bonbon08/pico-ledmatrix/README.md

# Pico LED-Matrix 16×16

Vier günstige WS2812B-8×8-Matrizen an einem Raspberry Pi Pico, zusammen eine Fläche von 16×16 Pixeln, versorgt nur über USB.
Dazu gehören 26 Animationen in MicroPython, eine PC-Oberfläche zum Hochladen und Streamen und ein Gehäuse zum 3D-Drucken.

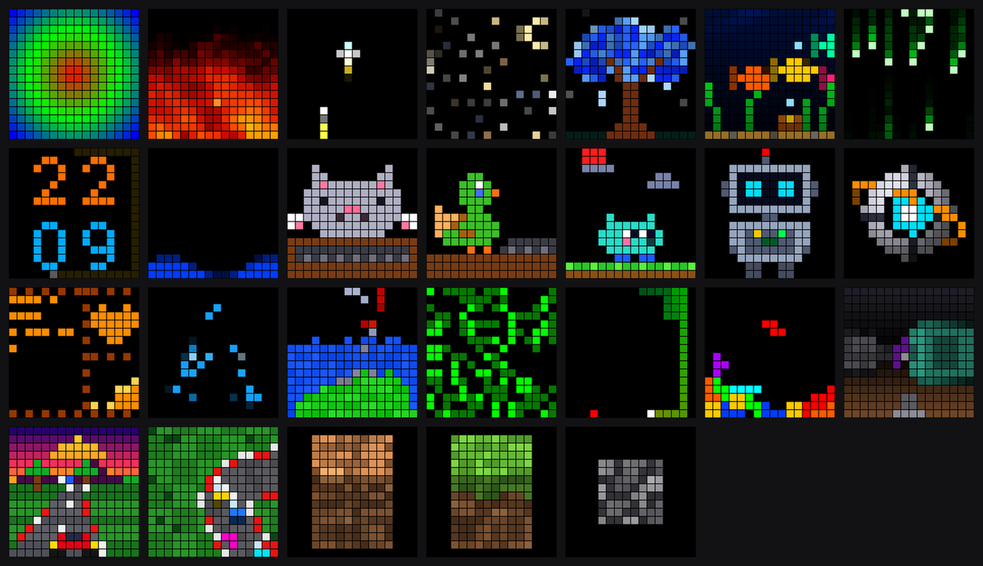
[picture p1: bilder/uebersicht.png]
Alle Demos auf einen Blick (PC-Vorschau)


*Die Bilder sind PC-Vorschauen von `tools/vorschau.py`, keine Fotos der echten Matrix.*

**Was es kann**

- **26 Demos**, die ohne PC laufen: Feuer, Feuerwerk, Aquarium, Uhr, Game of Life, ein Physik-Sandkasten, ein Raycasting-Shooter, zwei Autorennen, rotierende 3D-Blöcke und mehr.
- **Mit dem PC:** Sound-Visualizer, Video und Bildschirm live, eigene Bilder und GIFs, eine Bongo-Katze und eine Ente, die bei jedem Tastendruck mittippen.
- **Eine GUI** (`tools/gui.py`) für alles, mit Live-Vorschau jeder Demo auf dem PC.
- **Kein Netzteil nötig:** `matrix.py` dimmt auf etwa 6 % und begrenzt den Gesamtstrom, so reichen die 500 mA eines USB-Ports.
- **Parametrisches Gehäuse** in OpenSCAD mit Pixelraster und Diffusor.

**Schnellstart**

```bash
# MicroPython auf den Pico flashen (https://micropython.org/download/RPI_PICO/), dann:
uvx mpremote cp matrix.py :matrix.py + cp demos/feuer.py :main.py + reset
# oder alles über die GUI (braucht Python 3 mit tkinter, Pillow, pyserial):
python tools/gui.py
```

**Weitere Dokumentation**

- [Technischer Bericht](docs/technischer-bericht.md): Aufbau, Stromversorgung, Bildpipeline, Protokolle, Leistung, offene Punkte
- [Gehäuse](gehaeuse/README.md): Drucken, Zusammenbau, LED-Abstand ausmessen
- Diese Datei: Hardware, alle Demos, GUI, Werkzeuge und Einstellungen

## Hardware

| Was | Details |
|---|---|
| Controller | Raspberry Pi Pico (RP2040) mit MicroPython |
| LEDs | 4 × WS2812B 8×8 (64 LEDs je Matrix), in Reihe geschaltet |
| Daten | **GP22** → DIN von Matrix 1, DOUT → DIN der nächsten Matrix usw. |
| Versorgung | 5 V von VBUS (USB) und GND gemeinsam mit dem Pico |

### Anordnung der Matrizen

Reihenfolge in der Datenkette (von vorne gesehen):

```
┌─────────┬─────────┐
│    1    │    3    │
│ (0–63)  │(128–191)│
├─────────┼─────────┤
│    2    │    4    │
│ (64–127)│(192–255)│
└─────────┴─────────┘
```

Innerhalb jeder Matrix laufen die LEDs zeilenweise von links nach rechts und dann von oben nach unten, also nicht im Zickzack.

### Koordinaten

`xy(x, y)` rechnet eine Koordinate in den LED-Index um. (0,0) ist oben links, (15,15) unten rechts:

```python
def xy(x, y):
    m = (x // 8) * 2 + (y // 8)          # welche Matrix (0–3)
    return m * 64 + (y % 8) * 8 + (x % 8)
```

## Stromverbrauch und Helligkeit

Bei voller Helligkeit zieht eine WS2812B in Weiß bis zu ca. 60 mA. 256 LEDs kämen damit auf über 15 A, viel zu viel für USB (500 mA).
Deshalb begrenzt `MAX` in `matrix.py` jeden Farbkanal auf **16 von 255**, also etwa 6 %.

Zusätzlich gibt es eine **Strombremse**: `show()` addiert alle Farbwerte. Liegt die Summe über `BUDGET`, wird das ganze Bild gleichmäßig gedimmt. `BUDGET` entspricht dem Regenbogen, bei dem jede LED zusammen 255 hat. Damit bleiben auch Demos mit vielen weißen oder gelben Pixeln im sicheren Bereich.

Grobe Schätzung:

| Verbraucher | Strom |
|---|---|
| Ruhestrom der LEDs (0,6–1 mA pro LED, auch wenn sie aus sind) | 150–250 mA |
| Leuchten bei `MAX = 16` (ca. 1,25 mA pro LED) | ca. 320 mA |
| Pico | ca. 25 mA |
| **Summe** | **ca. 500 mA** |

Das ist etwa die Grenze eines USB-2.0-Ports. Gemessen wurde VSYS über ADC3 (GP29): Die Spannung fiel von 4,71 V (alle LEDs aus) gleichmäßig auf 4,61 V (MAX 22), ohne Einbruch.

> Ohne externes 5-V-Netzteil `MAX` nicht über ca. 22 stellen. Bei Flackern oder Abstürzen auf 12 zurückgehen.
> Mit Netzteil die 5 V direkt an die Matrizen führen und GND mit dem Pico verbinden.

## Dateien

| Datei | Zweck |
|---|---|
| `matrix.py` | Gemeinsame Bibliothek: Koordinaten, Helligkeit, Helligkeitsausgleich, Strombremse |
| `demos/regenbogen.py` | Regenbogen-Ringe von der Mitte nach außen |
| `demos/bloecke.py` | Fallende Blöcke: zufällige Steine aus je vier Pixeln stapeln sich, volle Reihen verschwinden ([Vorschau](bilder/bloecke.png)) |
| `demos/snake.py` | Snake, die von alleine spielt und meist das ganze Feld füllt |
| `demos/gameoflife.py` | Conways Game of Life mit Überblenden und Farbe nach Zellalter |
| `demos/feuer.py` | Lagerfeuer mit Flammenzungen, Wind und aufsteigenden Funken |
| `demos/uhr.py` | Uhr: oben Stunden, unten Minuten, Sekundenring am Rand (60 Pixel) |
| `demos/rennen_oben.py` | Autorennen von oben: 4 Autos auf einer 64×64-Strecke, Kamera fährt mit ([Vorschau](bilder/rennen_oben.png)) |
| `demos/rennen_hinten.py` | Autorennen von hinten (Pseudo-3D) mit Kurven, Sonnenuntergang, Palmen und Gegenverkehr ([Vorschau](bilder/rennen_hinten.png)) |
| `demos/shooter.py` | Ego-Shooter im 90er-Stil, der sich selbst spielt: Raycasting, eigenes Labyrinth, Schleimmonster ([Vorschau](bilder/shooter.png)) |
| `demos/visualizer.py` | Sound-Visualizer: 16 Frequenzbalken vom PC-Ton, braucht `tools/visualizer.py` auf dem PC |
| `demos/bongocat.py` | Bongo-Katze, die bei jedem Tastendruck am PC auf ihre Tastatur haut, braucht `tools/tastatur.py` ([Vorschau](bilder/bongocat.png)) |
| `demos/ente.py` | Tipp-Ente, die bei jedem Tastendruck am PC mit dem Schnabel auf ihre Tastatur pickt, braucht `tools/tastatur.py` ([Vorschau](bilder/ente.png)) |
| `demos/mampf.py` | Mampf, ein runder Knubbel, läuft über die Wiese, saugt herabfallendes Essen ein, kaut, rülpst Sterne und glüht nach Peperoni ([Vorschau](bilder/mampf.png)) |
| `demos/terminal.py` | Altes Bernstein-Terminal: Text tippt sich Zeile für Zeile, dazu Pixel-Symbole und ein hüpfender Pegel ([Vorschau](bilder/terminal.png)) |
| `demos/oslogo.py` | Logo des Betriebssystems vom PC (wie bei fastfetch), baut sich funkelnd auf, mit Glanzstreifen; das Logo erzeugt `tools/oslogo.py` ([Vorschau](bilder/oslogo.png)) |
| `demos/elemente.py` | Physik-Sandkasten: Sand, Wasser, Lava und Samen; Lava + Wasser = Stein + Dampf, Pflanzen wachsen und brennen ([Vorschau](bilder/elemente.png)) |
| `demos/kikern.py` | Rotierende 3D-Panzerkugel mit leuchtendem Auge und Ring, starrt ab und zu rot den Betrachter an ([Vorschau](bilder/kikern.png)) |
| `demos/video.py` | Video vom PC abspielen (16×16, bis 50 Bilder/s), braucht `tools/video.py`; ohne PC pulsiert ein Play-Symbol ([Vorschau](bilder/video.png)) |
| `demos/roboter.py` | Kleiner Roboter, der schaut, blinzelt, winkt, tanzt, sich verliebt und einschläft ([Vorschau](bilder/roboter.png)) |
| `demos/kopfstein.py` | Pflastersteinblock im Minecraft-Stil, der um alle drei Achsen taumelt ([Vorschau](bilder/kopfstein.png)) |
| `demos/matrixcode.py` | Grüner Matrix-Code-Regen mit flackernden Zeichen ([Vorschau](bilder/matrixcode.png)) |
| `demos/erdblock.py` | Rotierender 3D-Erdblock im Minecraft-Stil, optional als Grasblock ([Erde](bilder/erdblock.png), [Gras](bilder/grasblock.png)) |
| `demos/feuerwerk.py` | Feuerwerk mit Kugeln, Ringen, Goldregen und Glitzer, mit Nachleuchten ([Vorschau](bilder/feuerwerk.png)) |
| `demos/aquarium.py` | Aquarium mit Fischen, Seegras, Schatztruhe und Luftblasen ([Vorschau](bilder/aquarium.png)) |
| `demos/sternhimmel.py` | Funkelnde Sterne, Mondsichel und gelegentliche Sternschnuppen ([Vorschau](bilder/sternhimmel.png)) |
| `demos/kirschbaum.py` | Blauer Kirschblütenbaum bei Nacht mit fallenden Blütenblättern ([Vorschau](bilder/kirschbaum.png)) |
| `tools/testbild.py` | Testbild zum Prüfen der Ausrichtung |
| `tools/visualizer.py` | PC-Seite des Sound-Visualizers |
| `tools/tastatur.py` | PC-Seite der Bongo-Katze und der Tipp-Ente: meldet Tastendrücke (nur die Tastaturreihe) und Loslassen an den Pico |
| `tools/oslogo.py` | Holt das Logo von fastfetch, rechnet es auf 16×16 um und lädt es mit der Demo hoch |
| `tools/video.py` | PC-Seite des Videos: dekodiert mit ffmpeg (Dateien oder Links über yt-dlp) und streamt an den Pico |
| `tools/vorschau.py` | Vorschaubild einer Demo auf dem PC erzeugen, ohne Pico; mit `--live` läuft sie in Echtzeit (für die GUI) |
| `tools/bildschirm.py` | PC-Bildschirm live an den Pico streamen (Wayland über die Bildschirmfreigabe, X11 über ffmpeg) |
| `tools/gui.py` | GUI für alles: Demos mit Live-Vorschau, Bilder/GIFs, Video und Bildschirm, OS-Logo, Werkzeuge |
| `tools/starten.sh` | Starter für den Startmenü-Eintrag: holt per `git pull` die neueste Version und startet die GUI |
| `tools/symbol.png` | Symbol für Startmenü und Fenster |
| `demos/_bild.py` | Player für eigene Bilder/GIFs (lädt die GUI zusammen mit `bild.bin` hoch) |
| `gehaeuse/` | 3D-Druck-Gehäuse (OpenSCAD + STL) |

## GUI

```bash
python tools/gui.py
```

Alles, was die Werkzeuge in `tools/` können, geht auch über die GUI. Benötigt werden `tkinter`, Pillow und pyserial, je nach Funktion zusätzlich numpy und `parec` (Visualizer), ffmpeg (Video), fastfetch (OS-Logo) sowie python-gobject und gst-plugin-pipewire (Bildschirm unter Wayland). `mpremote` wird verwendet, wenn es installiert ist, sonst über `uvx mpremote` gestartet.

Oben steht, ob der Pico verbunden ist (grüner Punkt), was gerade auf der Matrix läuft und welcher PC-Sender aktiv ist. Unten steht das Protokoll, es lässt sich ausblenden.

- **Demos:** Eine **Live-Vorschau** lässt die gewählte Demo animiert auf dem PC laufen (`tools/vorschau.py --live`). Über der Liste gibt es eine Suche. „Auf die Matrix laden“, ein Doppelklick oder Enter lädt die Demo hoch, `matrix.py` wird dabei immer mitgeschickt.
  - Bei der **Uhr** übernimmt die GUI die PC-Zeit und startet ohne Reset.
  - Beim **Sound-Visualizer**, der **Bongo-Katze** und der **Tipp-Ente** startet danach der passende PC-Sender. Fehlt das Recht, die Tastatur mitzulesen, steht der nötige Befehl zum Kopieren gleich dabei.
- **Bild / GIF:** PNG, GIF, JPG, BMP oder WebP öffnen. Die Vorschau zeigt das Ergebnis in 16×16, GIFs animiert.
  - *Einpassen* lässt schwarze Ränder, *Zuschneiden* füllt die ganze Fläche, *Strecken* verzerrt.
  - *Helligkeit anheben* streckt alle Bilder mit demselben Faktor so, dass der hellste Wert 255 ist.
  - *Scharf skalieren* ist für Pixel-Art gedacht und wird bei Bildern bis 32 Pixel automatisch eingeschaltet.
  - *GIF-Tempo* von 0,25× bis 3×. Hochgeladen werden höchstens 400 Bilder (etwa 300 KB im Flash).
- **Video & Bildschirm:** Quelle wählen (Videodatei, Link oder den Bildschirm dieses PCs), dazu Zuschnitt, Bilder pro Sekunde, Farbe und Kontrast, beim Bildschirm auch einen Ausschnitt. „Starten“ lädt bei Bedarf den Empfänger (`demos/video.py`) und startet `tools/video.py` bzw. `tools/bildschirm.py`. Daneben steht die Bildrate, die der Pico meldet.
- **OS-Logo:** Logo wählen (Standard: dieser PC, sonst jeder Name aus `fastfetch --list-logos`), Kontrast mit zwei Reglern einstellen, das Ergebnis in 16×16 ansehen und mit der Demo hochladen.
- **Werkzeuge:**
  - Testbild (`tools/testbild.py`), Neustart und Ausschalten (LEDs aus, `main.py` löschen).
  - Uhr stellen.
  - Audioquelle für den Visualizer.
  - Prüfung der Tastatur-Rechte.
  - Dateien und freier Speicher auf dem Pico.
  - **Ins Startmenü:** legt `~/.local/share/applications/ledmatrix.desktop` an. Der Eintrag startet `tools/starten.sh`, das vorher `git pull --ff-only` macht, so läuft immer die neueste Version. Ohne Netz, auf einem anderen Branch oder bei lokalen Änderungen, die im Weg sind, startet die vorhandene Version. Was passiert ist, steht im Protokoll.

Neue Demos in `demos/` erscheinen automatisch in der Liste. Der Name kommt aus `NAMES` in `tools/gui.py`, sonst aus dem Kopfkommentar der Demo (`# Demo: Name. Beschreibung`). Hinweise unter der Beschreibung stehen in `HINTS`. Dateien, die mit `_` beginnen, sind keine Demos.

### Format von `bild.bin`

`b"LEDB"`, Anzahl Bilder (uint16, little endian), dann je Bild: Dauer in ms (uint16) und 768 Byte RGB, zeilenweise von oben links.
Der Player liest die Bilder einzeln aus dem Flash. Deshalb müssen auch lange GIFs nicht in den Arbeitsspeicher.

## Installation

Benötigt wird [`mpremote`](https://docs.micropython.org/en/latest/reference/mpremote.html), z. B. über `uv`.
Zuerst einmal die Bibliothek hochladen, dann die gewünschte Demo als `main.py`:

```bash
uvx mpremote cp matrix.py :matrix.py
uvx mpremote cp demos/regenbogen.py :main.py + reset
```

`main.py` startet automatisch beim Einschalten. Der Treiber `neopixel` ist in MicroPython für den RP2040 schon enthalten.

### Uhr

Der Pico hat keine Uhr mit Batterie. Nach jedem Einstecken und nach jedem Hardware-Reset steht die Zeit auf dem 1.1.2021, die Uhr zeigt dann blinkend `-- --`.
Deshalb die Zeit beim Hochladen vom PC übernehmen und `main.py` ohne Reset starten:

```bash
uvx mpremote cp demos/uhr.py :main.py + rtc --set + exec --no-follow "import main"
```

### Sound-Visualizer

Der PC schneidet den Ton mit, der gerade abgespielt wird (PipeWire/PulseAudio, Monitor des Standard-Ausgangs). Daraus berechnet er 16 logarithmisch verteilte Frequenzbänder von 40 Hz bis 16 kHz und schickt sie etwa 40-mal pro Sekunde per USB an den Pico.
Die Lautstärke wird automatisch nachgeregelt. Kommen 2 Sekunden lang keine Daten an, zeigt der Pico eine blaue Warte-Welle.

```bash
uvx mpremote cp demos/visualizer.py :main.py + reset
python tools/visualizer.py          # benötigt parec, numpy, pyserial; Strg+C beendet
```

Solange `tools/visualizer.py` läuft, belegt es den USB-Port. `mpremote` funktioniert dann nicht.
Übertragen werden nur druckbare Zeichen (`'0'` + Pegel 0–64 je Band, dann ein Zeilenende). So landet nie versehentlich ein Strg+C beim Pico.

### OS-Logo

Zeigt das Logo des Betriebssystems, das `fastfetch` auf dem PC anzeigt. `tools/oslogo.py` holt das farbige ASCII-Logo, zeichnet es mit einer Monospace-Schrift und rechnet es flächengemittelt auf 16×16 herunter. Das Ergebnis (`oslogo.bin`, 768 Byte) wird mit der Demo auf den Pico kopiert. Danach braucht es keinen PC mehr. Ohne `oslogo.bin` zeigt die Demo ein Fragezeichen.

```bash
python tools/oslogo.py --upload                 # Logo dieses PCs
python tools/oslogo.py --logo debian --upload   # anderes Logo (Liste: fastfetch --list-logos)
python tools/oslogo.py --png /tmp/logo.png      # nur ansehen, nichts hochladen
```

Die GUI macht das beim Hochladen der Demo automatisch.

### Video

`tools/video.py` dekodiert ein Video mit ffmpeg, schneidet es quadratisch zu, verkleinert es auf 16×16 und hebt Farbe und Kontrast etwas an. Danach streamt es das Video Bild für Bild an den Pico. Links von Videoseiten löst es mit yt-dlp auf.

```bash
uvx mpremote cp demos/video.py :main.py + reset
python tools/video.py film.mp4                       # einmal abspielen
python tools/video.py film.mp4 --schleife --modus rand   # endlos, ganzes Bild mit Rand
python tools/video.py "https://..." --fps 30         # Link, 30 Bilder/s
```

Pro Bild gehen `#`, 768 Zeichen `0`–`o` (6 Bit je Farbe) und ein Zeilenende zum Pico, also nur druckbare Zeichen. Getestet sind 50 Bilder/s ohne Aussetzer. Kommt der Pico nicht hinterher, lässt der Sender Bilder aus, damit das Video im Takt bleibt. Der Pico meldet alle 5 Sekunden seine Bildrate zurück.

### Bildschirm

`tools/bildschirm.py` zeigt den PC-Bildschirm live auf der Matrix. Auf dem Pico läuft dafür derselbe Empfänger wie beim Video (`demos/video.py`). Unter Wayland läuft die Aufnahme über die Bildschirmfreigabe des Desktops (xdg-desktop-portal und PipeWire). Beim ersten Mal fragt der Desktop in einem Dialog, welcher Bildschirm geteilt werden soll. Die Erlaubnis wird in `~/.cache/ledmatrix-bildschirm.token` gespeichert. Unter X11 nimmt ffmpeg auf.

```bash
python tools/bildschirm.py                        # ganzer Bildschirm, oben/unten schwarzer Rand
python tools/bildschirm.py --bereich 0.25,0.25,0.5,0.5   # nur die Mitte (x, y, Breite, Höhe)
python tools/bildschirm.py --neu                  # Bildschirm neu auswählen
```

### Bongo-Katze

Die Katze haut bei jedem Tastendruck am PC auf ihre Tastatur, abwechselnd mit der linken und der rechten Pfote. Ohne PC trommelt sie im Demo-Modus von selbst, nach 30 Sekunden ohne Tastendruck schläft sie ein.

`tools/tastatur.py` liest die Tastatur direkt aus `/dev/input`. Das funktioniert auch unter Wayland und unabhängig davon, welches Fenster aktiv ist. Dafür muss der Benutzer einmalig in die Gruppe `input`:

```bash
sudo usermod -aG input $USER      # danach ab- und wieder anmelden
uvx mpremote cp demos/bongocat.py :main.py + reset
python tools/tastatur.py
```

Zum Pico geht pro Tastendruck nur ein `k`, nie welche Taste gedrückt wurde. Dazu kommt jede Sekunde ein `.` als Lebenszeichen.
Wichtig: Mit der Gruppe `input` dürfen **alle** Programme dieses Benutzers die Tastatur mitlesen, nicht nur dieses. Wem das zu weit geht, der lässt die Katze im Demo-Modus laufen.

### Tipp-Ente

Funktioniert genauso wie die Bongo-Katze und nutzt denselben Sender: Bei jedem Tastendruck beugt die Ente den Hals vor und pickt auf eine Taste, die aufleuchtet. Welche ihrer drei Tasten, hängt von der Reihe der echten Taste ab: obere Reihen (Ziffern, QWERTZ, F-Tasten) hinten, mittlere Reihe in der Mitte, untere Reihe mit Leertaste vorne, alles andere zufällig. Der Sender schickt dafür nur die Reihe, nie die Taste. Solange eine Taste gehalten wird, bleibt der Schnabel unten. Bei schnellem Tippen richtet sie sich zwischen den Picks nicht ganz auf. Ohne PC pickt sie im Demo-Modus von selbst, nach 30 Sekunden ohne Tastendruck steckt sie den Kopf ein und schläft.

```bash
uvx mpremote cp demos/ente.py :main.py + reset
python tools/tastatur.py
```

## Eigene Demos

```python
import matrix as m

m.clear()
m.set(0, 0, (255, 0, 0))      # Pixel oben links rot, Farben immer 0-255
m.set(15, 15, m.wheel(300))   # Farbe aus dem Farbrad (0-767)
m.show()                      # dimmt, korrigiert und sendet an die LEDs
```

Ein Vorschaubild ohne Pico erzeugt `python tools/vorschau.py demos/meine_demo.py bilder/meine_demo.png 30,60,90`. Die Zahlen sind die Nummern der Bilder, die nebeneinander gezeigt werden.

`show()` braucht etwa 8 ms. Die Umrechnung läuft mit `@micropython.viper` als nativer Code, der Rest ist das Senden an die LEDs.

## Testbild

```bash
uvx mpremote run tools/testbild.py
```

Wenn die Zuordnung stimmt, siehst du:

- **Rot:** die komplette oberste Zeile (16 LEDs)
- **Grün:** die komplette linke Spalte (16 LEDs)
- **Gelb:** einen Punkt bei (1,1)
- **Blau:** einen Punkt ganz unten rechts (15,15)

Das Testbild bleibt nur bis zum nächsten Reset. Danach startet wieder `main.py`.

## Anpassen

- **Helligkeit:** `MAX` in `matrix.py`
- **Helligkeitsausgleich je Matrix und Farbe:** `GAIN` in `matrix.py`. Matrix 1 hat andere LEDs: Rot und Grün leuchten doppelt so hell, Blau etwa 1,45-mal. Sie läuft deshalb mit (0,5; 0,5; 0,69). Die Werte wurden per Auge mit einfarbigen Testbildern abgeglichen.
- **Regenbogen:** Die Geschwindigkeit stellt man über `off + 12` und `time.sleep_ms(20)` ein. Ein größerer Faktor in `int(d * 48)` ergibt schmalere Ringe.
- **Rennen von oben:** Die Strecke steht in `POINTS` als Eckpunkte einer geschlossenen Runde (Welt 64×64). `ROAD` und `CURB` sind die halbe Straßenbreite und die Breite der Randsteine. Die Autofarben stehen in `CARS`. Beim Start wird die Strecke etwa 4 Sekunden lang berechnet, solange ist ein Ladebalken zu sehen.
- **Rennen von hinten:** Die Strecke steht in `TRACK` als Abschnitte (Länge, Krümmung; negativ = links). `SPEED` ist das Tempo, `PX` die Straßenbreite.
- **Shooter:** Das Labyrinth steht in `MAP` (`#` Stein, `B` Ziegel, `T` Technik, `.` frei). `ENEMIES` ist die Anzahl der Gegner, `SHOOT_DIST` der Abstand, ab dem geschossen wird. `MOVE` und `TURN` bestimmen das Tempo.
- **Roboter:** Farben stehen oben in der Datei. Welche Zustände wie oft vorkommen, regelt `next_state()`.
- **Pflasterstein:** `SPIN` ist das Drehtempo um die drei Achsen, `STONES` das Steinmuster (8×8).
- **Matrix-Code:** `DROPS` ist die Anzahl der Spuren pro Spalte, `DECAY` die Schweiflänge, `GLYPH_FLIP` wie oft Zeichen wechseln.
- **Erdblock:** Mit `GRASS = True` wird daraus ein Grasblock. `SPIN` ist das Drehtempo, `TILT` die Neigung (negativ = von oben gesehen), `ZOOM` die Größe (kleiner = größer).
- **Feuerwerk:** `LAUNCH` ist die Häufigkeit der Raketen, `FINALE` die Häufigkeit eines Finales mit 4 Raketen. `TRAIL` bestimmt die Länge der Leuchtspuren. `MAX_SPARKS` begrenzt die Funken, damit der Pico flüssig bleibt.
- **Aquarium:** `FISH` ist die Anzahl der Fische (Farben in `FISH_COLS`), `BUBBLE_RATE` die Häufigkeit der Luftblasen. Die Fischform steht in `FISH_ART`, das Seegras in `WEEDS` als (x, Höhe).
- **Sternhimmel:** `STARS` ist die Anzahl der Sterne, `SHOOT` die Häufigkeit der Sternschnuppen (0,006 = etwa alle 7 Sekunden). Mit `MOON` lässt sich der Mond ein- und ausschalten.
- **Kirschbaum:** Die Form steht als Pixel-Art in `ART` (B = Blüte, T = Stamm, G = Boden, * = Stern), die Farben in `BLUES`. `PETALS` und `PETAL_RATE` steuern die Blütenblätter.
- **Tipp-Ente:** Die Ente steht als Pixel-Art in `ART` (Körper) und `HEAD` (Kopfhaltungen, darunter eine pro Taste), die Farben in `COL`. In `KEYS` steht je Taste die Kopfhaltung, die leuchtenden Pixel und die Stelle der Funken. `PECK` ist der Ablauf eines Picks (eine Zahl pro Bild), `SLEEP_AFTER` die Zeit bis zum Einschlafen.
- **Mampf:** `SPAWN` ist die Häufigkeit des Essens, `MAX_ITEMS` die Höchstzahl gleichzeitig. Das Essen steht in `ITEMS` als 3×3-Pixel-Art mit Gewicht (je höher, desto häufiger). `SPEED` und `HOT_SPEED` sind das Lauftempo, `BURP_AFTER` die Happen bis zum Rülpser. Die Figur steht in `BODY`, `MOUTH` und `FEET`, die Farben in `COL`.
- **Terminal:** `TYPE_FRAMES` ist das Tipptempo, `LINE_PAUSE` und `VERSE_PAUSE` die Pausen nach Zeile und Strophe, `VERSE_LINES` die Zeilen pro Strophe. Die Symbole stehen in `ICONS` (6×6), die Farben in `AMBER`, `FRESH` und `FRAME`.
- **OS-Logo:** `HOLD` ist die Standzeit, `GLINT_EVERY` der Abstand der Glanzstreifen, `BUILD_SPEED` das Tempo von Aufbau und Zerfall. In `tools/oslogo.py` regeln `LOW` und `HIGH` den Kontrast beim Umrechnen (höheres `LOW` = weniger schwache Randpixel), `ANSI` die Farben.
- **Elemente:** In `POUR` stehen die Gieß-Phasen (Material, alle wie viele Bilder ein Pixel, Gewicht). `FULL` ist die Füllung, ab der der Boden aufgeht, `KEEP` wie viel dabei übrig bleibt. Farben in `PAL`, Flackern und Körnung in `VAR`. Die Regeln (wer sinkt durch wen, Reaktionen) stehen in `step()`, die Dichten in `MD` und `TD`.
- **KI-Kern:** `SPIN` ist das Drehtempo, `TILT` das Kippen, `RADIUS` die Kugelgröße. `STARE_EVERY` und `STARE` regeln das Anstarren. Farben in `ARMOR`, `SEAM`, `EYE` und `ANGRY`. In `RINGS` lassen sich weitere Ringe eintragen (Neigung, Radius, Tempo, Farbe).
- **Video:** Am Sender: `--fps`, `--farbe` (Sättigung, Standard 1,4), `--kontrast` (Standard 1,15), `--modus` (`zuschneiden`, `rand` oder `strecken`), `--schleife`. In der Demo: `TIMEOUT`, nach wie vielen ms ohne Bild das Play-Symbol erscheint.
- **Feuer:** `COOL` bestimmt die Flammenhöhe (größer = niedriger). `EMBER` ist die Häufigkeit der Funken, `WIND` die Häufigkeit von Windwechseln.
- **Game of Life:** `FRAMES` und `FRAME_MS` bestimmen das Tempo (eine Generation = `FRAMES × FRAME_MS`, also ca. 190 ms). `DENSITY` ist die Startdichte beim Zufallsstart.
- **Snake:** `STEP_MS` ist die Zeit pro Schritt. Eine komplette Runde dauert bei 80 ms etwa 15 Minuten.
- **Fallende Blöcke:** `FALL_MS` ist die Fallgeschwindigkeit. `SMART` ist der Anteil der Steine, die gut gelegt werden. Je höher der Wert, desto mehr Reihen werden voll.

## Fehlersuche

- **LEDs bleiben dunkel oder flackern:** Der 3,3-V-Datenpegel des Pico reicht bei 5-V-LEDs manchmal nicht ganz. Hilfreich sind dann ein Widerstand von 330 Ω in der Datenleitung, eine kurze Leitung oder ein Pegelwandler (z. B. 74AHCT125). Außerdem prüfen, ob GND gemeinsam verbunden ist.
- **Farben vertauscht:** Andere LED-Typen verwenden eine andere Kanalreihenfolge (z. B. RGB statt GRB).
- **Bild verdreht oder gespiegelt:** Mit dem Testbild prüfen und `xy()` anpassen.

## Gehäuse

Ein Gehäuse zum 3D-Drucken (Rahmen mit Pixelraster und Diffusor, Deckel mit Pico-Halter) liegt in [`gehaeuse/`](gehaeuse/README.md).

## Lizenz

[MIT](LICENSE), © 2026 bonbon. Das gilt für Code, Gehäuse-Dateien und Bilder in diesem Repository.

Einige Demos sind an bekannte Spielgenres angelehnt („im Minecraft-Stil“, Raycasting-Shooter, fallende Blöcke). Grafik, Levels und Namen sind selbst gemacht, Texturen werden im Code erzeugt. Das Projekt hat nichts mit den Inhabern dieser Spiele oder Marken zu tun. Die OS-Logos erzeugt `fastfetch` auf dem eigenen PC, sie sind nicht Teil des Codes. Das Vorschaubild `bilder/oslogo.png` (und die Kachel in `bilder/uebersicht.png`) zeigt das Arch-Linux-Logo. Es gehört dem Arch-Linux-Projekt und fällt nicht unter die MIT-Lizenz.
