bonbon08/pico-ledmatrix/bilder/aquarium.png

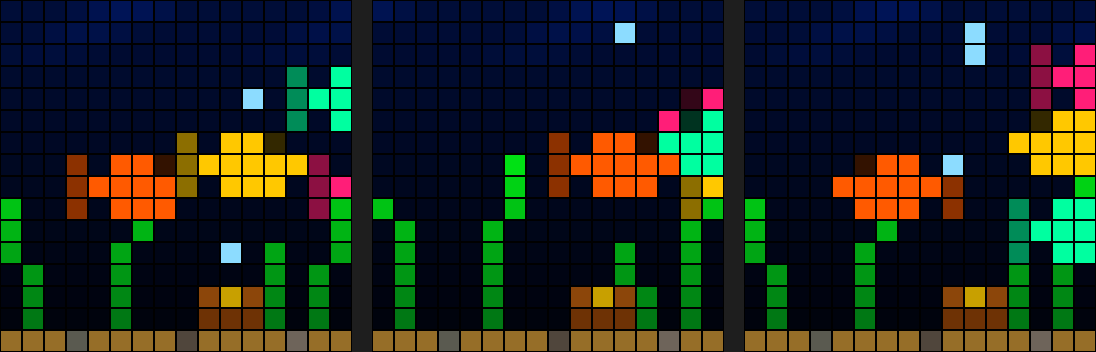
bilder/aquarium.png
