bonbon08/pico-ledmatrix/bilder/bloecke.png

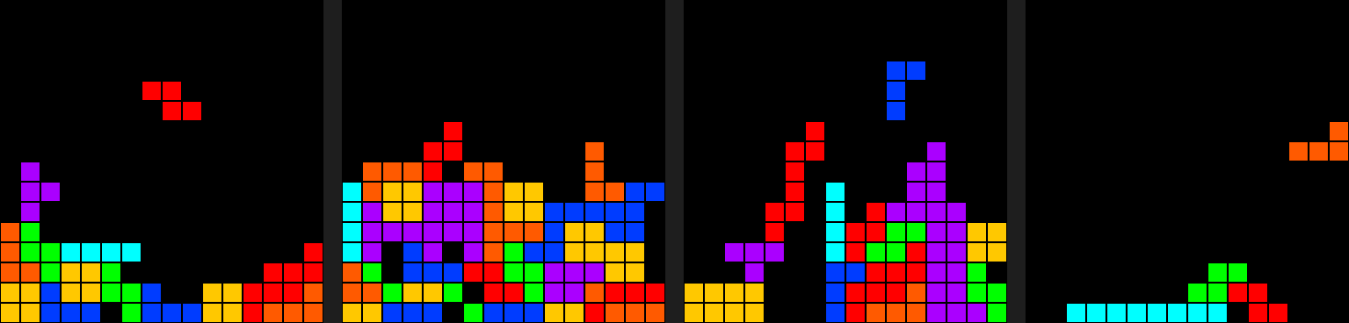
bilder/bloecke.png
