bonbon08/pico-ledmatrix/bilder/bongocat.png

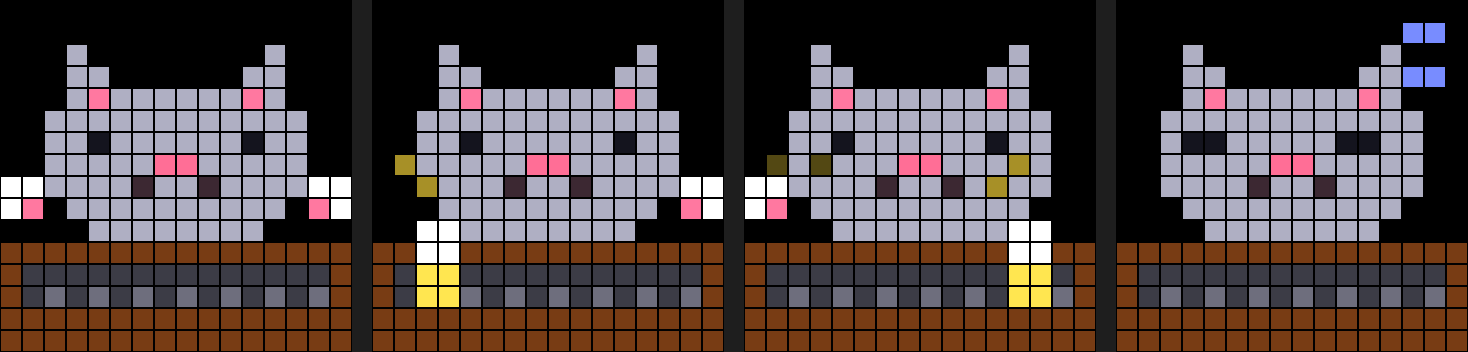
bilder/bongocat.png
