bonbon08/pico-ledmatrix/bilder/elemente.png

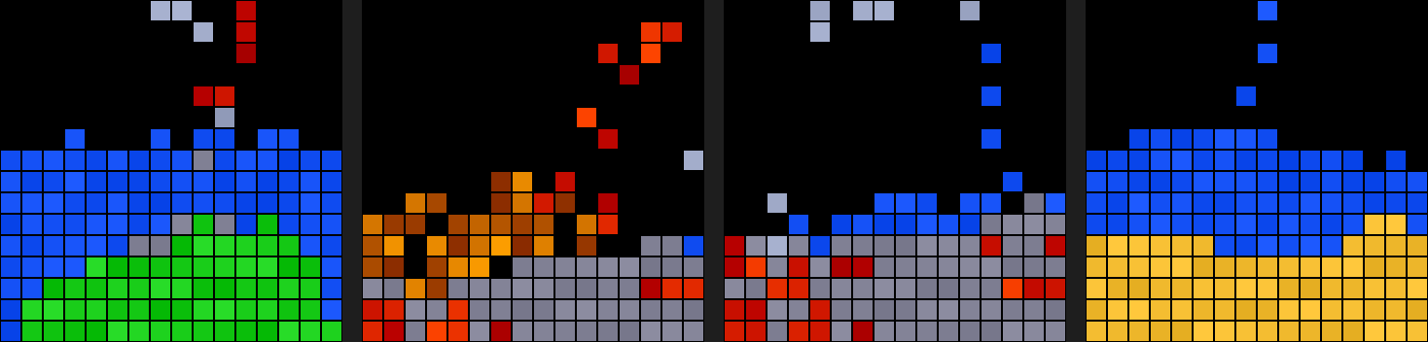
bilder/elemente.png
