bonbon08/pico-ledmatrix/bilder/ente.png

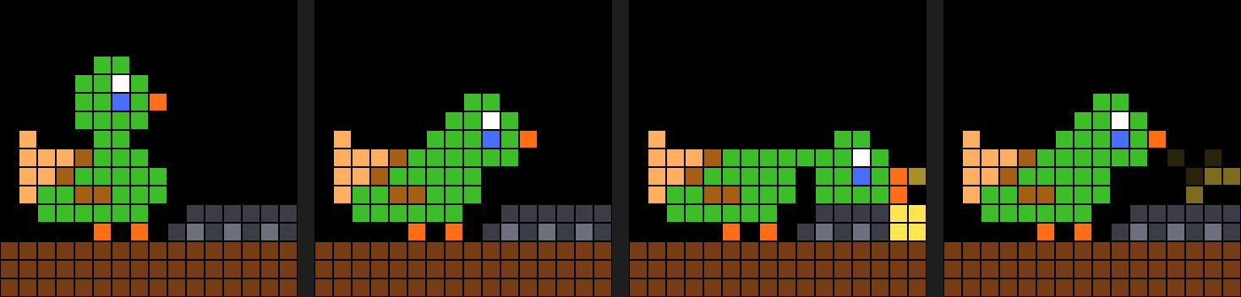
bilder/ente.png
