bonbon08/pico-ledmatrix/bilder/erdblock.png

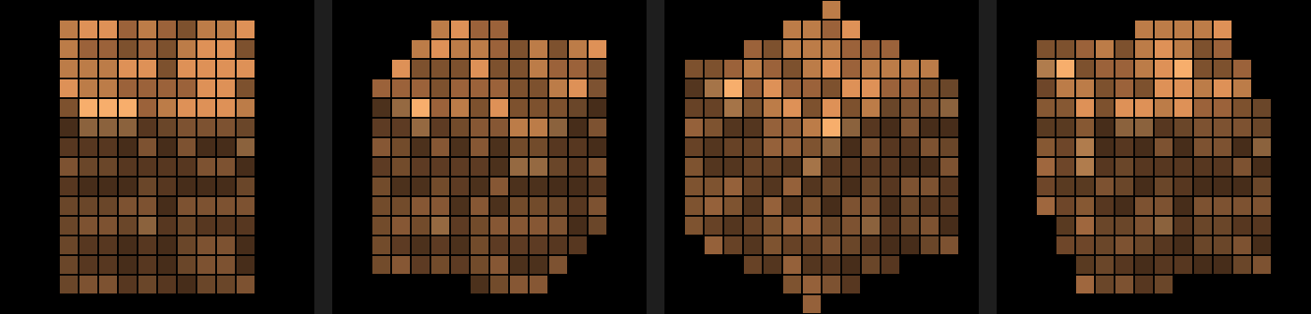
bilder/erdblock.png
