bonbon08/pico-ledmatrix/bilder/feuer.png

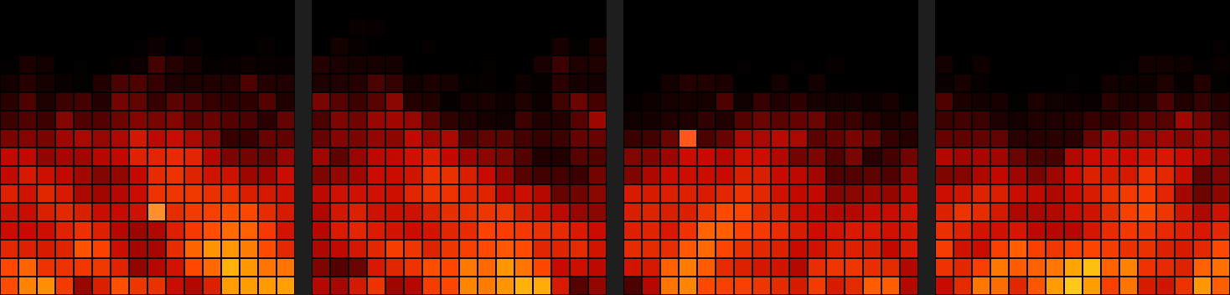
bilder/feuer.png
