bonbon08/pico-ledmatrix/bilder/feuerwerk.png

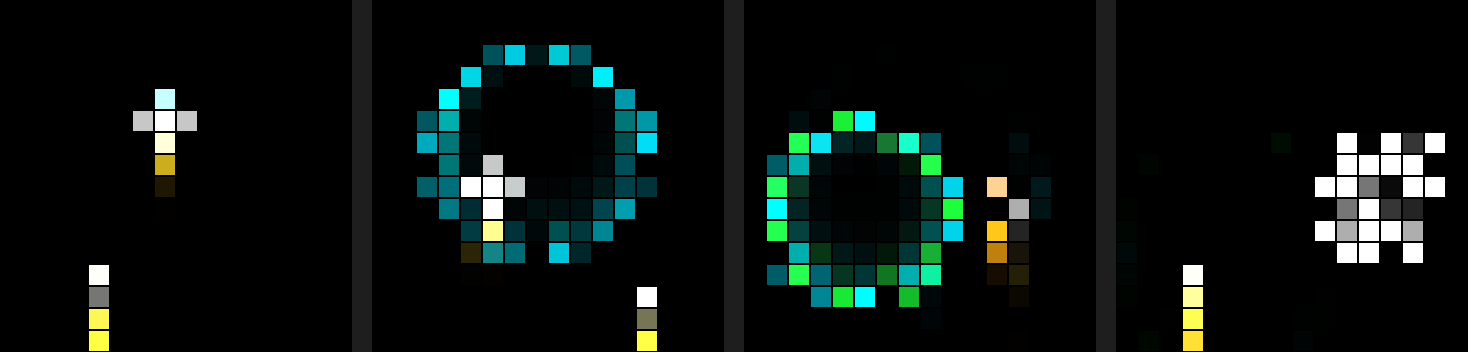
bilder/feuerwerk.png
