bonbon08/pico-ledmatrix/bilder/gameoflife.png

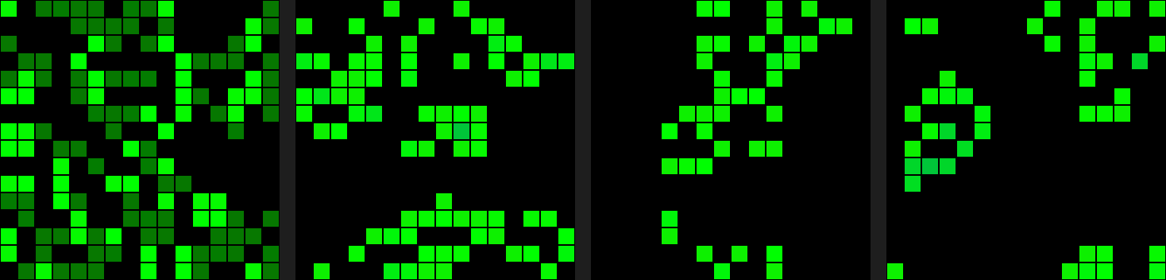
bilder/gameoflife.png
