bonbon08/pico-ledmatrix/bilder/kikern.png

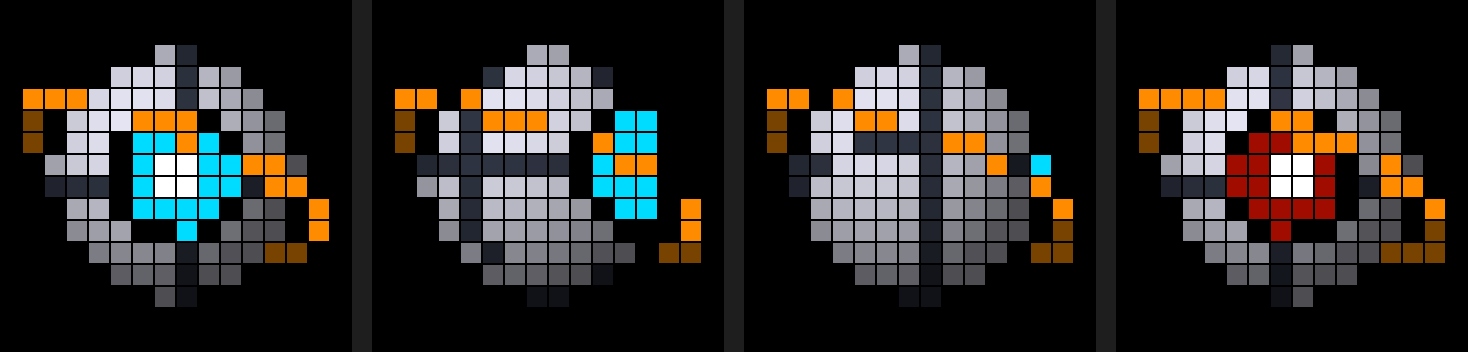
bilder/kikern.png
