bonbon08/pico-ledmatrix/bilder/kirschbaum.png

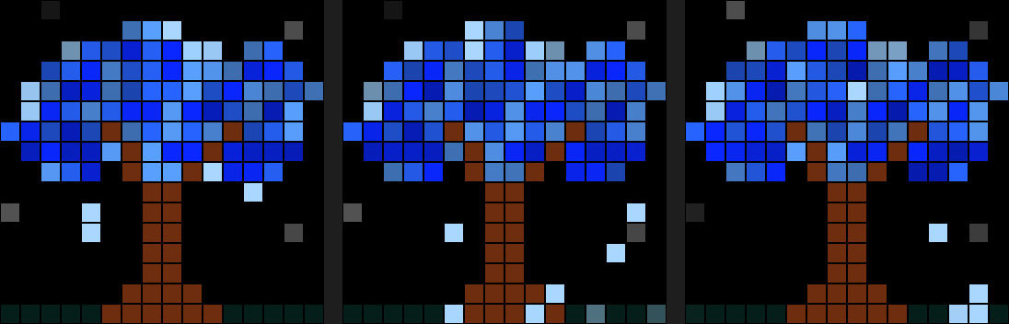
bilder/kirschbaum.png
