bonbon08/pico-ledmatrix/bilder/kopfstein.png

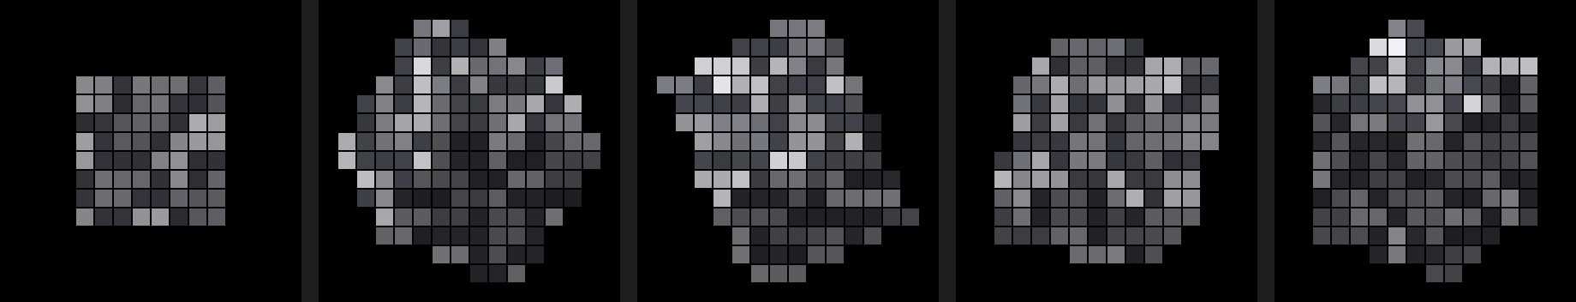
bilder/kopfstein.png
