bonbon08/pico-ledmatrix/bilder/mampf.png

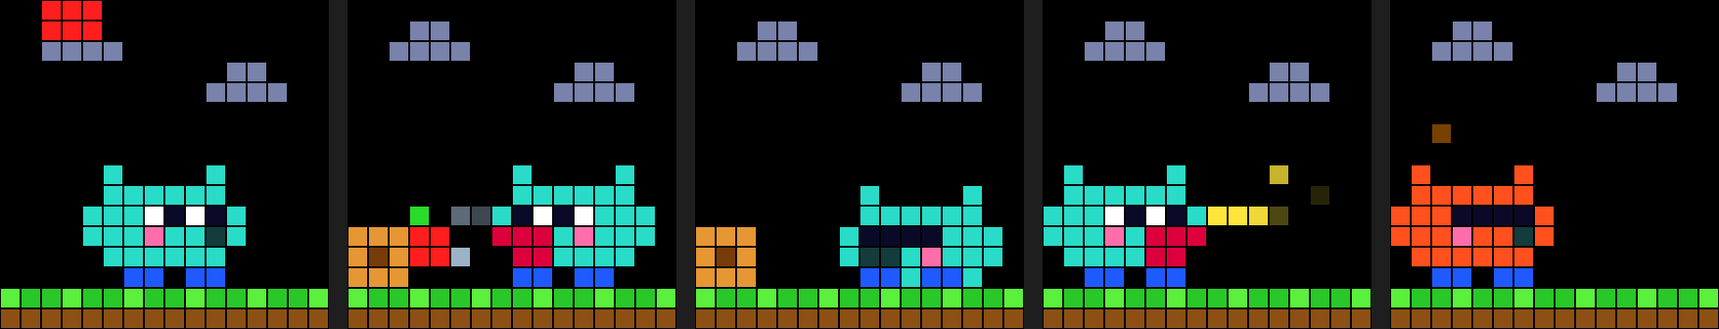
bilder/mampf.png
