bonbon08/pico-ledmatrix/bilder/matrixcode.png

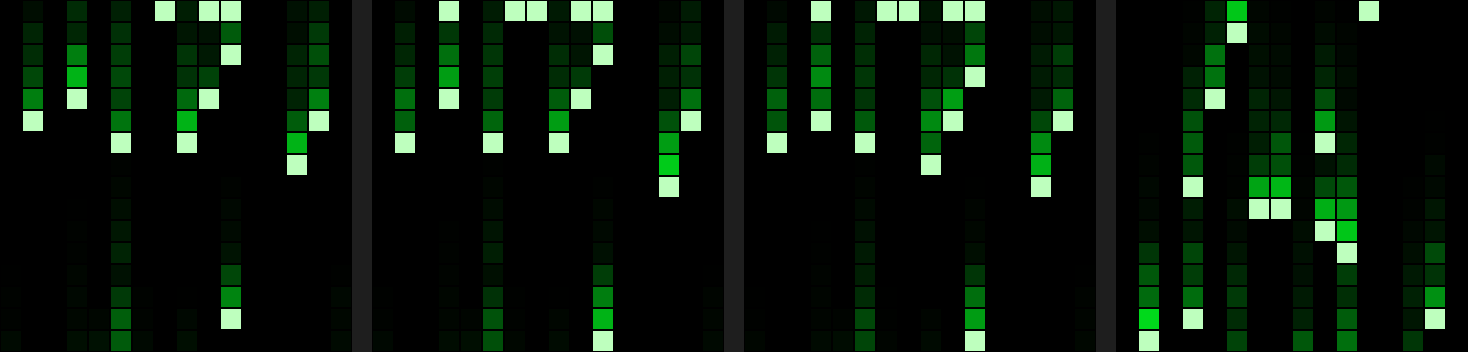
bilder/matrixcode.png
