bonbon08/pico-ledmatrix/bilder/regenbogen.png

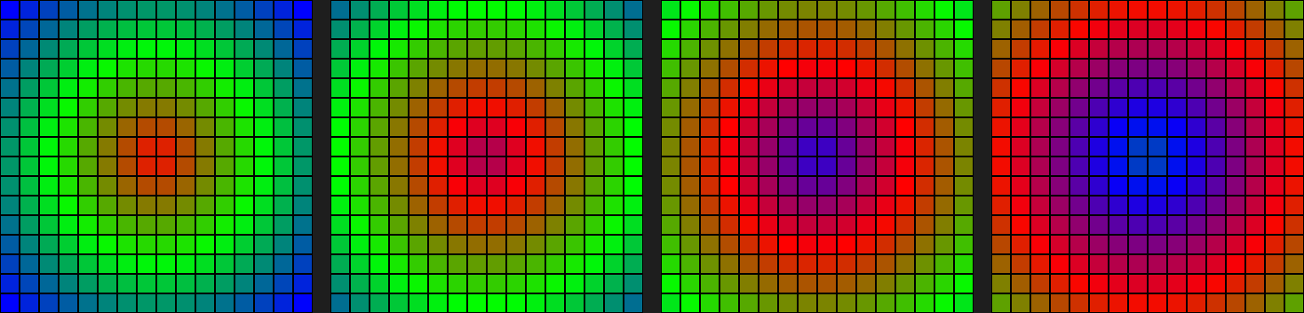
bilder/regenbogen.png
