bonbon08/pico-ledmatrix/bilder/rennen_hinten.png

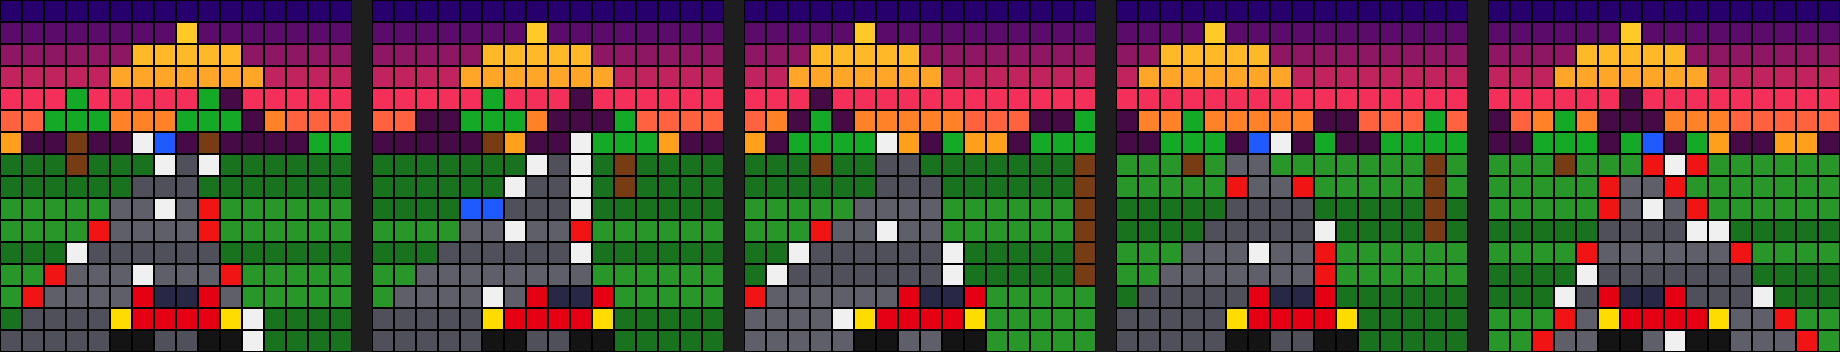
bilder/rennen_hinten.png
