bonbon08/pico-ledmatrix/bilder/rennen_oben.png

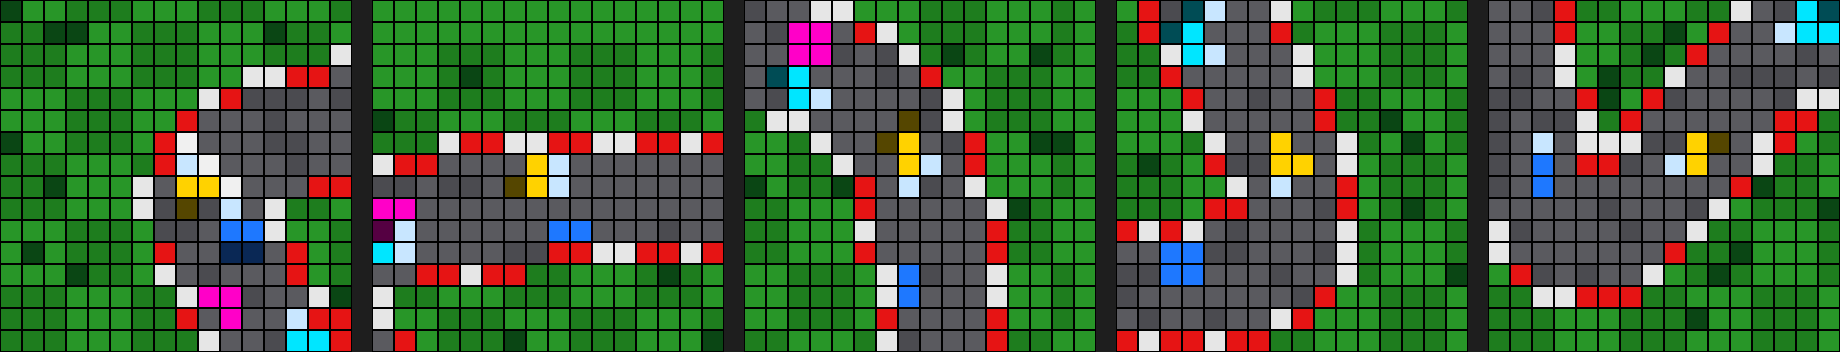
bilder/rennen_oben.png
