bonbon08/pico-ledmatrix/bilder/roboter.png

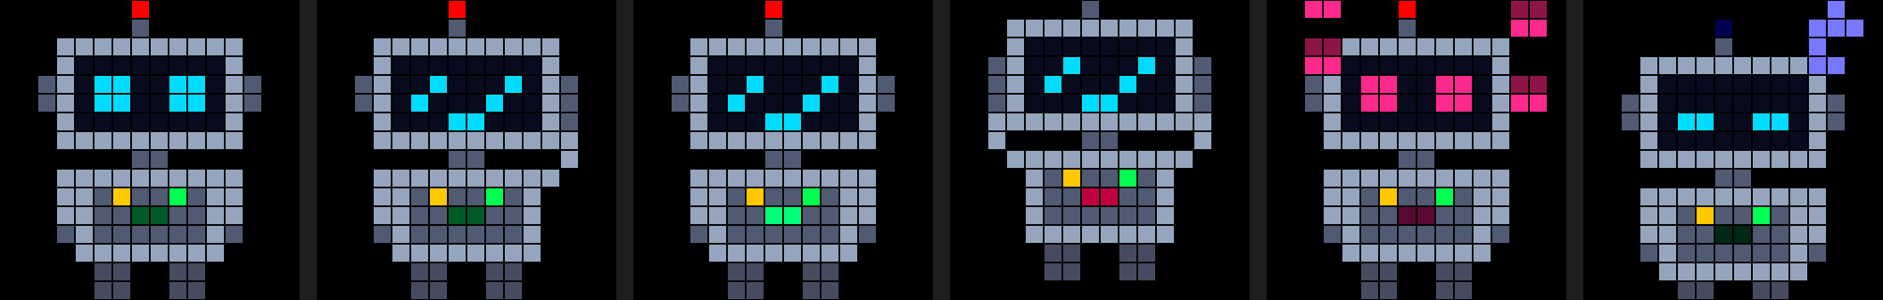
bilder/roboter.png
