bonbon08/pico-ledmatrix/bilder/shooter.png

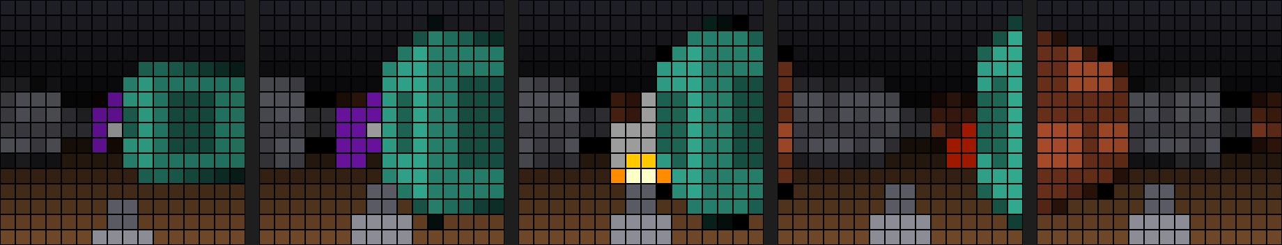
bilder/shooter.png
