bonbon08/pico-ledmatrix/bilder/snake.png

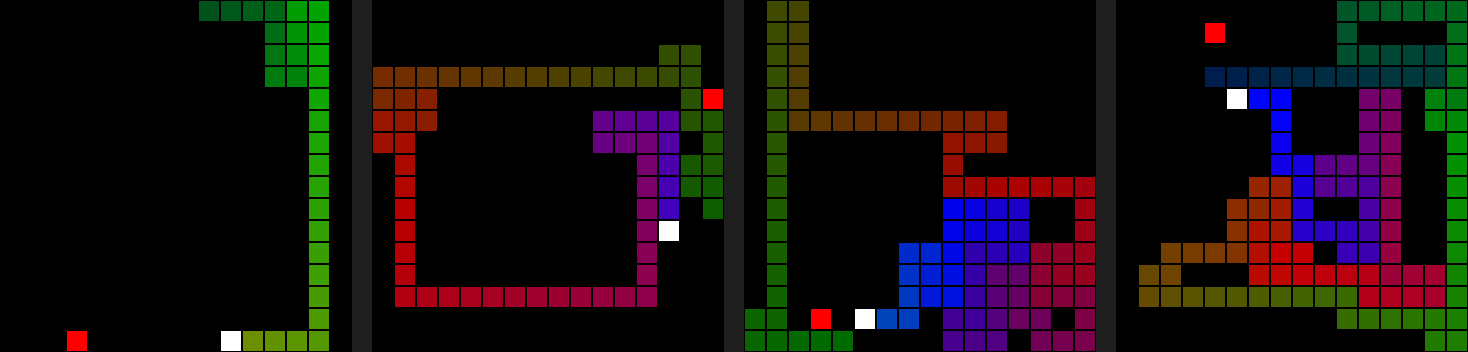
bilder/snake.png
