bonbon08/pico-ledmatrix/bilder/sternhimmel.png

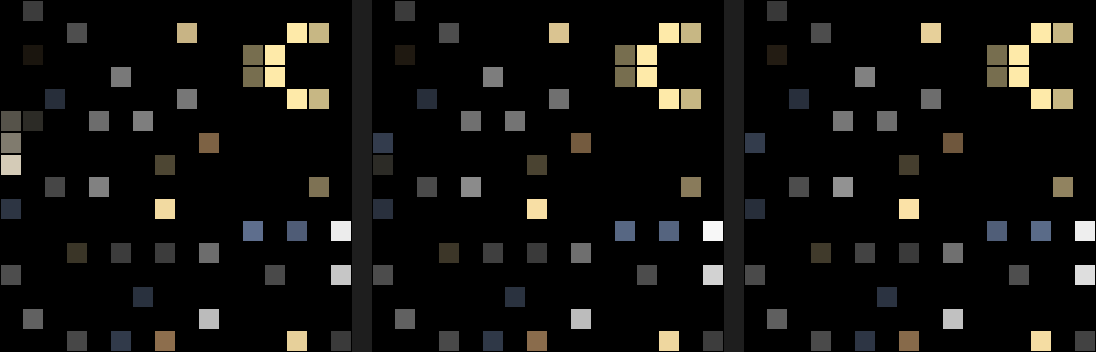
bilder/sternhimmel.png
