bonbon08/pico-ledmatrix/bilder/terminal.png

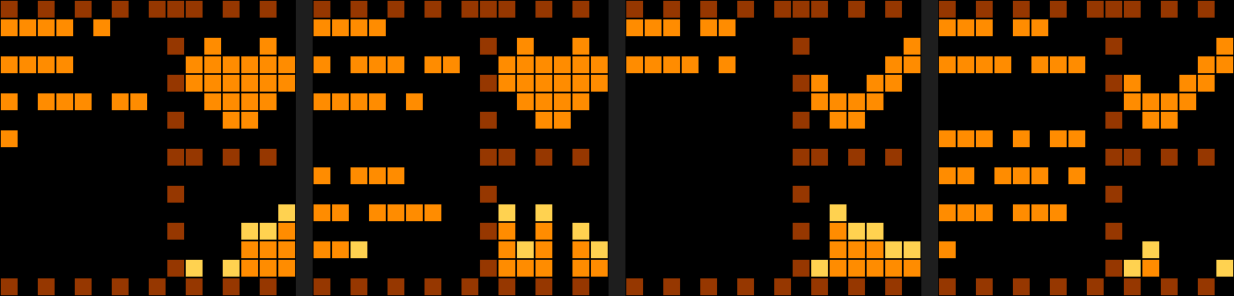
bilder/terminal.png
