bonbon08/pico-ledmatrix/bilder/uhr.png

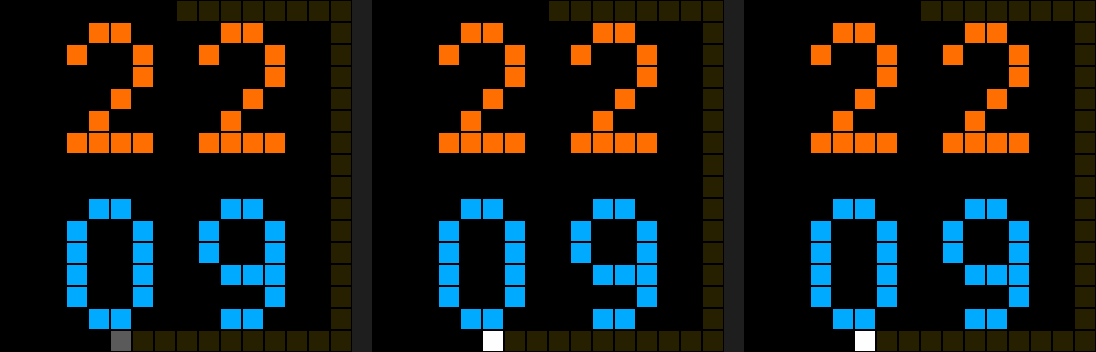
bilder/uhr.png
