bonbon08/pico-ledmatrix/bilder/video.png

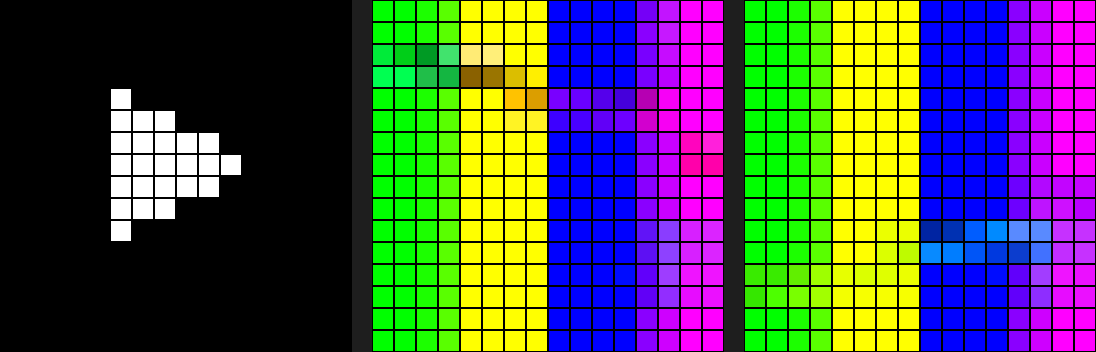
bilder/video.png
