bonbon08/pico-ledmatrix/bilder/visualizer.png

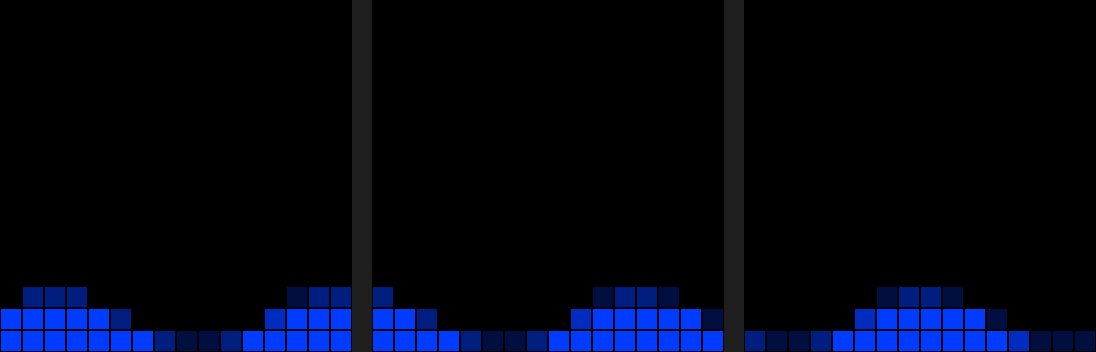
bilder/visualizer.png
