bonbon08/pico-ledmatrix/tools/symbol.png

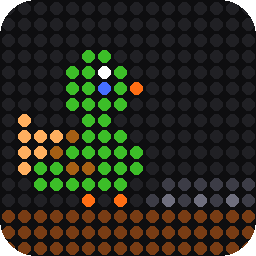
tools/symbol.png
