bonbon08/pico-ledmatrix/gehaeuse/deckel.stl

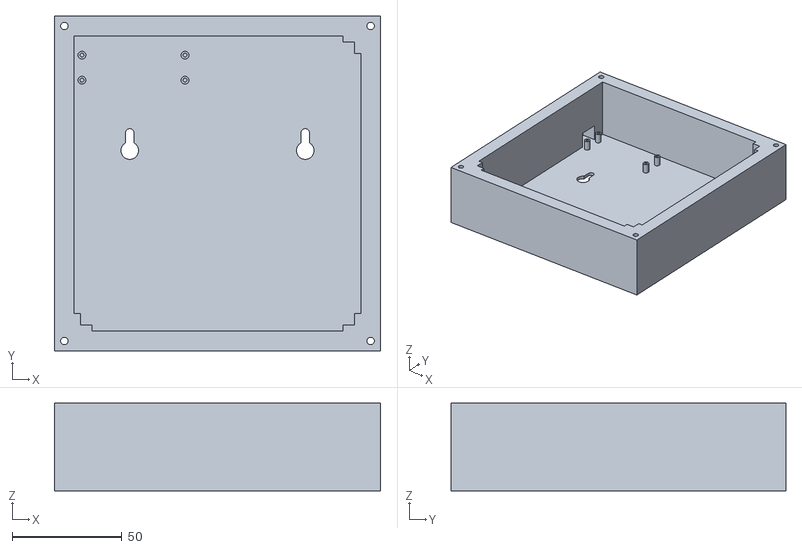
[picture p30: CAD file, 2026-10-26]
gehaeuse/deckel.stl
148.6 x 152.6 x 40.0
