bonbon08/pico-ledmatrix/gehaeuse/front.stl

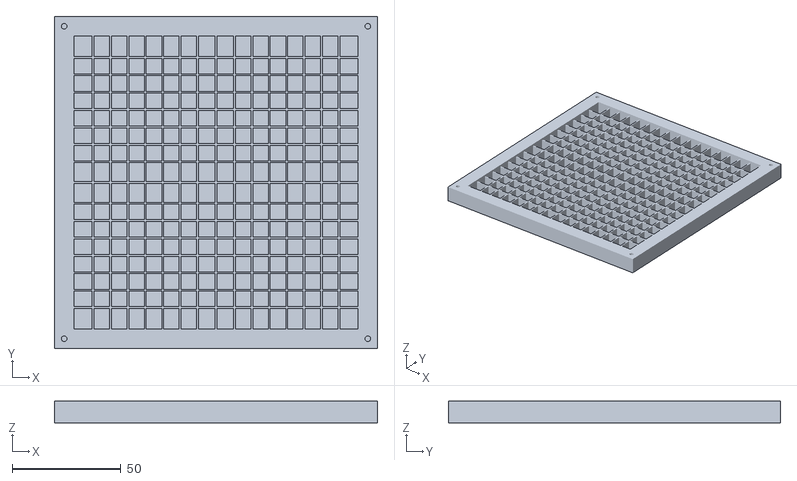
[picture p31: CAD file, 2026-10-26]
gehaeuse/front.stl
148.6 x 152.6 x 10.0
