bonbon08/pico-ledmatrix/gehaeuse/lehre.stl

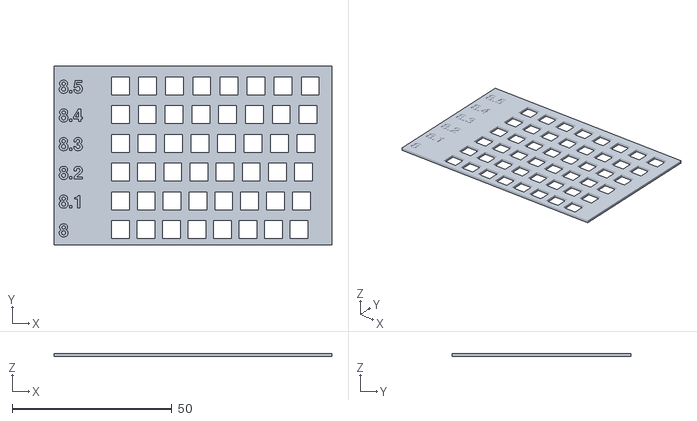
[picture p32: CAD file, 2026-10-26]
gehaeuse/lehre.stl
87.1 x 56.0 x 1.00
