bonbon08/pico-ledmatrix/(commit log)

2026-10-25 LED-Matrix 16x16 Regenbogen-Animation mit Doku
2026-10-25 3D-Druck-Gehäuse für Matrizen und Pico
    [deckel.stl, front.stl, gehaeuse.scad]
2026-10-25 Bibliothek matrix.py mit Strombremse, Demos Regenbogen und Tetris
2026-10-25 Demo: Snake, die von alleine spielt
2026-10-25 Demos: Matrix-Code und rotierender Erdblock
2026-10-25 Demos: Autorennen von oben und von hinten
2026-10-25 GUI zum Hochladen von Demos und eigenen Bildern/GIFs, Vorschaubilder für alle Demos
2026-10-26 Gehäuse: Deckel 1 cm tiefer, nur Eckhalter, versenkte Schrauben, Messlehre für den LED-Abstand
    [deckel.stl, front.stl, gehaeuse.scad, lehre.stl]
2026-10-26 Claude-Konfiguration: CLAUDE.md und Skill /neue-demo
2026-10-26 GUI: neu gestaltet, alle Werkzeuge integriert, Bildschirm-Sender
    - Demos mit Live-Vorschau (vorschau.py --live), Suche und Hinweisen
    - Reiter Video & Bildschirm, OS-Logo und Werkzeuge (Testbild, Uhr,
    Audioquelle, Tastatur-Rechte, Dateien/Speicher)
    - dunkles Design, Statusanzeige für Pico, Matrix und Sender
    - tools/bildschirm.py: Bildschirm live streamen (Wayland über
    xdg-desktop-portal/PipeWire, X11 über ffmpeg)
    - video.py: --modus zuschneiden/rand/strecken
2026-10-26 Tipp-Ente: Taste je nach Tastaturreihe, gehaltene Tasten bleiben gedrückt; GUI im Startmenü mit Auto-Update
    Der Tastatur-Sender meldet jetzt die Reihe der Taste (q/a/y, sonst k) und das
    Loslassen (l), das Lebenszeichen sagt, ob noch etwas gehalten wird (h/.).
    Die Bongo-Katze versteht das neue Format ebenfalls.
    [gui.py, tastatur.py]
